bobasaurus/lumber-plunder-metal-detector/kicad/metal detector test/stm32 nucleo board jumpers and solder bridges.xlsx

nucleo-f303k8 (STM32F303K8T6) |  |  |  | (powered using VIN pin at 11.1V nominally, nucleo supports 7-12V on that pin officially, max nucleo current < 300 mA
 |  |  |  | When powered from VIN or +5 V, it is still possible to use ST-LINK for communication for programming or debugging only, but it is mandatory to power the board first, using VIN or +5 V, then to connect the USB cable to the PC.
(on nucleo) | (TRUE = on/connected/soldered/bridged)
Jumper | Default | Desired | change? | Function | Notes
SB1 | FALSE | FALSE |  | off = tells host pc that up to 300 mA max will be drawn from USB power, on = only 100 mA max will be drawn (makes USB enumeration suceed more often) | Must be off for VIN power
SB2 | TRUE | TRUE |  | on = PA2 operates as backchannel TX, off = PA2 operates as A7 pin and is disconnected from ST-LINK | lumber plunder's SW6 will only work if this jumper is off and LP_JP2 is on. Defaulting to enable backchannel tx for initial debugging, will change this later | IS ACCESSABLE AFTER SOLDERING NUCLEO
SB3 | TRUE | TRUE |  | on = PA15 operates as backchannel RX, off = PA15 is not connected | not connected to any header pins, no conflict
SB4 | FALSE | TRUE | yes |  | MCO 8 MHz from ST-LINK connected to OSCIN (PF0)
SB5 | FALSE | FALSE |  |  | MCO 8 MHz from ST-LINK connected to OSCIN (PF0)
SB6 | TRUE | FALSE | yes |  | MCO 8 MHz from ST-LINK connected to OSCIN (PF0)
SB7 | FALSE | FALSE |  |  | MCO 8 MHz from ST-LINK connected to OSCIN (PF0)
SB8 | TRUE | TRUE |  |  | MCO 8 MHz from ST-LINK connected to OSCIN (PF0)
SB9 | TRUE | TRUE |  | on = NRST from ST-LINK connected to STM32 (normal operation), off = NRST disconnected for powering from 3.3V or 5V pins
SB10 | TRUE | TRUE |  | on = VREF+ on STM32 is connected to nucleo 3.3v regulator, off = disconnect nucleo 3.3v reg from vref and use external pin's vref instead (see LP_JP5) | lumber plunder's LP_JP5 must be off if this jumper is on, and vice versa. Defaulting to using the nucleo's internal vref for now... will try changing it later to see if it affects stability. | NOTE: NOT ACCESSABLE AFTER SOLDERING NUCLEO!!!
SB11 | TRUE | TRUE |  | on = PB2 is grounded, off = PB2 is open | not connected to any header pins, no conflict
SB12 | TRUE | TRUE |  | on = pin 31 is pulled to gnd for boot0 | not connected to any header pins, no conflict
SB13 | TRUE | TRUE |  | on = Pin 32 of STM32 (U2) is connected to VSS | not connected to any header pins, no conflict
SB14 | TRUE | TRUE |  | on = use internal 3.3v regulator for uC VDD, off = disconnect internal regulator
SB15 | TRUE | FALSE | yes | on = Green user LED LD3 is connected to D13, off = D13 is available to use as gpio | we need this for oled spi, so change to the open position
SB16 | TRUE | FALSE | yes | on = STM32 PB6 is connected to both A5 and D5 for I2C support and D5 is unusable, off = PB6 is just for D5 gpio | we need this open to use D5 for SW0 and A5 for audio dac output
SB17 | FALSE | FALSE |  |  | MCO 8 MHz from ST-LINK connected to OSCIN (PF0)
SB18 | TRUE | FALSE | yes | on = PB7 is connected to both A4A and D4 for I2C support and D4 is unusable, off = PB7 is just for D4 gpio | we need this for SW1, so change to the open position
JP1 | TRUE | TRUE |  | on = STM32 is powered, off = an ammeter must be connected for STM32 power | (on bottom of board, 90 deg connector) Labeled IDD, used to measure the STM32 microcontroller consumption by removing the jumper and connecting an ammeter
Lumber Plunder PCB Jumpers
Jumper | Default | Desired | change? | Function | Notes
LP_JP1 | FALSE | FALSE |  | on = 9v power connected to the analog transmit oscillator, off = analog transmit oscillator unpowered
LP_JP2 | FALSE | FALSE |  | on = SW6 connected... be sure to open SB2 backchannel tx jumper on nucleo, off = SW6 disconnected so we can use backchannel tx | Defaulting to enable backchannel tx for initial debugging, will change this later
LP_JP3 | FALSE | TRUE | yes | on = use nucleo 5v to power oled (jumper near nucleo) (must be opposite state of LP_JP4)
LP_JP4 | FALSE | FALSE |  | on = use nucleo 3.3v to power oled (must be opposite state of LP_JP3 and LP_JP6)
LP_JP5 | FALSE | FALSE |  | on = use lumber plunder's analog 3.3v as vref, off = use internal nucleo 3.3V regulator for vref | Leave this off for now to see how well the nucleo's reference does... then compare later to my analog 3.3v. The internal nucleo 3.3v goes through a series inductor at least.
LP_JP6 | FALSE | TRUE | yes | on = use nucleo 5v to power oled (jumper near nucleo) (must be opposite state of LP_JP4)
