bobasaurus/lumber-plunder-metal-detector/visual studio/sine_wave_resolution_test/sine_wave_resolution_test/dac test.xlsx

dac count | dac voltage [V]
0 | 0 |  | volts per dac step: | 0.0008056640625
1 | 0.0008058608059 |  | max voltage | 1.722124542
2 | 0.001611721612 |  | min voltage | 1.577069597
3 | 0.002417582418 |  | peak to peak voltage of sine wave generator: | 0.1450549451
4 | 0.003223443223 |  | number of steps peak to peak: | 180.043956
5 | 0.004029304029 |  | number of steps center to peak: | 90.02197802
6 | 0.004835164835
7 | 0.005641025641
8 | 0.006446886447
9 | 0.007252747253
10 | 0.008058608059
11 | 0.008864468864
12 | 0.00967032967
13 | 0.01047619048
14 | 0.01128205128
15 | 0.01208791209
16 | 0.01289377289
17 | 0.0136996337
18 | 0.01450549451
19 | 0.01531135531
20 | 0.01611721612
21 | 0.01692307692
22 | 0.01772893773
23 | 0.01853479853
24 | 0.01934065934
25 | 0.02014652015
26 | 0.02095238095
27 | 0.02175824176
28 | 0.02256410256
29 | 0.02336996337
30 | 0.02417582418
31 | 0.02498168498
32 | 0.02578754579
33 | 0.02659340659
34 | 0.0273992674
35 | 0.02820512821
36 | 0.02901098901
37 | 0.02981684982
38 | 0.03062271062
39 | 0.03142857143
40 | 0.03223443223
41 | 0.03304029304
42 | 0.03384615385
43 | 0.03465201465
44 | 0.03545787546
45 | 0.03626373626
46 | 0.03706959707
47 | 0.03787545788
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
