bobasaurus/lumber-plunder-metal-detector/images/lumber plunder metal detector schematic v1.pdf

# 6W Audio Amplifier for Transmitter

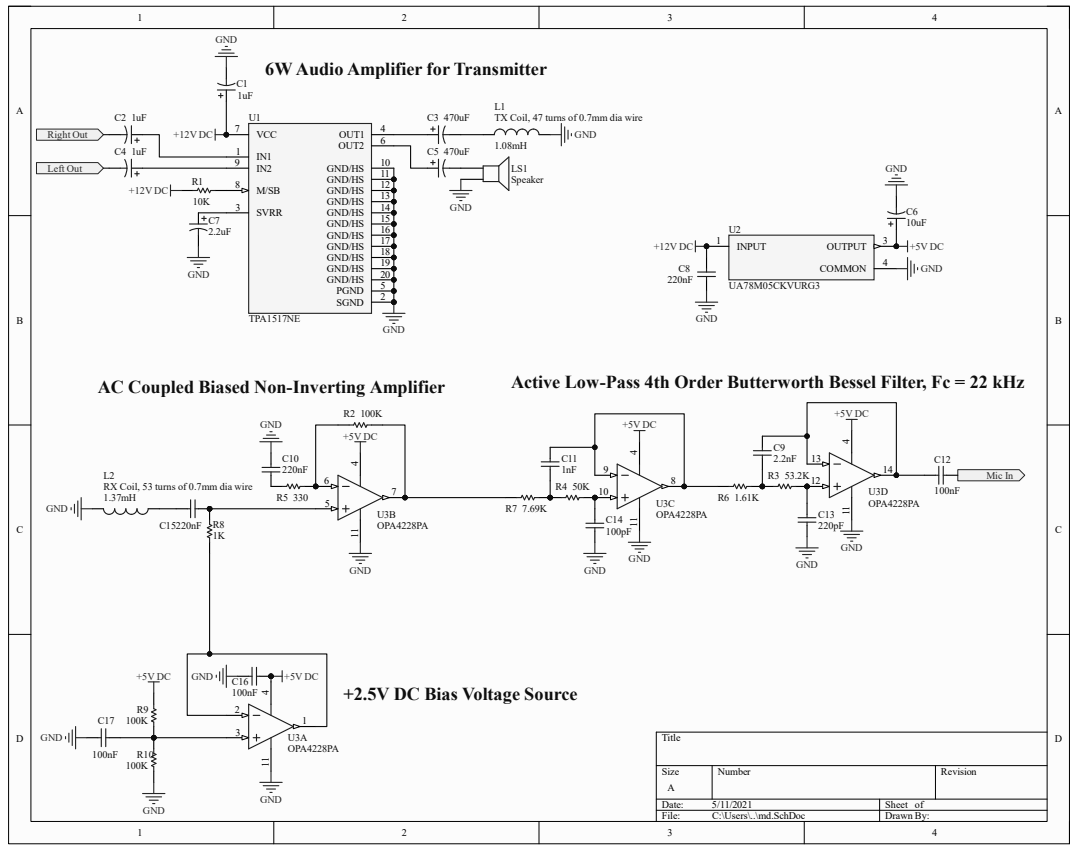
[picture p6: page 1]

TX Coil, 47 turns of 0.7mm dia wire

RX Coil, 53 turns of 0.7mm dia wire

+2.5V DC Bias Voltage Source
