bobasaurus/lumber-plunder-metal-detector/ltspice/metal detector tx range test.asc

C1: cap; 43n
C2: cap; 33n
Lrx: ind2; 6m1
Ltx: ind2; 5m9
Q1: npn
Q2: pnp
R1: res; 560
R2: res; 1k2
R3: res; 27k
R4: res; 12k
R5: res; 2k
R6: res; 18k
R7: res; 100k
R8: res; 5k1
R9: res; 5k1
R10: res; 50k
R11: res; 50k
R12: res; 100k
R13: res; 18k
U1: opamp
U2: opamp
V1: voltage; 9
V2: voltage; 1.65
V3: voltage; 9
Named nets: 0, VOutTxADC, VTxOsc, VOutRxADC
.tran 0 20m 12m 1u
.lib opamp.sub
.meas TRAN txVoltageForADCMax MAX V(VOutTxADC)
.meas TRAN txVoltageForADCMin MIN V(VOutTxADC)
.meas TRAN rxVoltageForADCMax MAX V(VOutRxADC)
.meas TRAN rxVoltageForADCMin MIN V(VOutRxADC)
K1 Ltx Lrx .001
todo: resistor divider for U1 bias, then use uC DAC for U2 bias
