bobasaurus/lumber-plunder-metal-detector/ltspice/diff amp.asc

R1: res; 10k
R2: res; 10k
R3: res; 50k
R4: res; 50k
RL: res; 1m
U1: opamp
V2: voltage; SINE(0 .1 10000)
Named nets: 0
.tran 0 1m 0 1u
.lib opamp.sub
