bobasaurus/lumber-plunder-metal-detector/ltspice/metal detector 5v proto.asc

C1: cap; 47n
C2: cap; 33n
Lrx: ind2; 6m2; Rser=25.3
Ltx: ind2; 5m6; Rser=24.5
Q1: npn; 2N3904
Q2: pnp; 2N3906
R1: res; 390
R2: res; 1k
R3: res; 47k
R4: res; 47k
R5: res; 1.5k
R6: res; 20k
R7: res; 100k
R8: res; 2.5k
R9: res; 2.5k
R10: res; 200k
R11: res; 200k
U1: opamp
U2: opamp
V1: voltage; 4.7
V2: voltage; 1.65
Named nets: 0, VOutTxADC, VTxOsc, VOutRxADC
.tran 0 40m 15m 10u
.lib opamp.sub
.meas TRAN txVoltageForADCMax MAX V(VOutTxADC)
.meas TRAN txVoltageForADCMin MIN V(VOutTxADC)
.meas TRAN rxVoltageForADCMax MAX V(VOutRxADC)
.meas TRAN rxVoltageForADCMin MIN V(VOutRxADC)
K1 Ltx Lrx .001
.meas TRAN VTxOsc_MAX MAX V(VTxOsc)
