bobasaurus/lumber-plunder-metal-detector/ltspice/two transistor oscillator.asc

C1: cap; 43n
L1: ind; 5m9
Q1: npn
Q2: pnp
R1: res; 560
R2: res; 1k2
R3: res; 27k
R4: res; 12k
R5: res; 2k
R9: res; 19k
R10: res; 100k
U1: opamp
V1: voltage; 9
V2: voltage; 1.4
Named nets: 0, Vout, Vosc
.tran 0 18m 16m 1u
.lib opamp.sub
.meas TRAN maxOutputVoltage MAX V(Vout)
.meas TRAN minOutputVoltage MIN V(Vout)
