bobasaurus/lumber-plunder-metal-detector/kicad/metal detector test/metal detector test.kicad_pcb

## KiCad design kicad/metal detector test/metal detector test.kicad_pcb (2023-10-08)

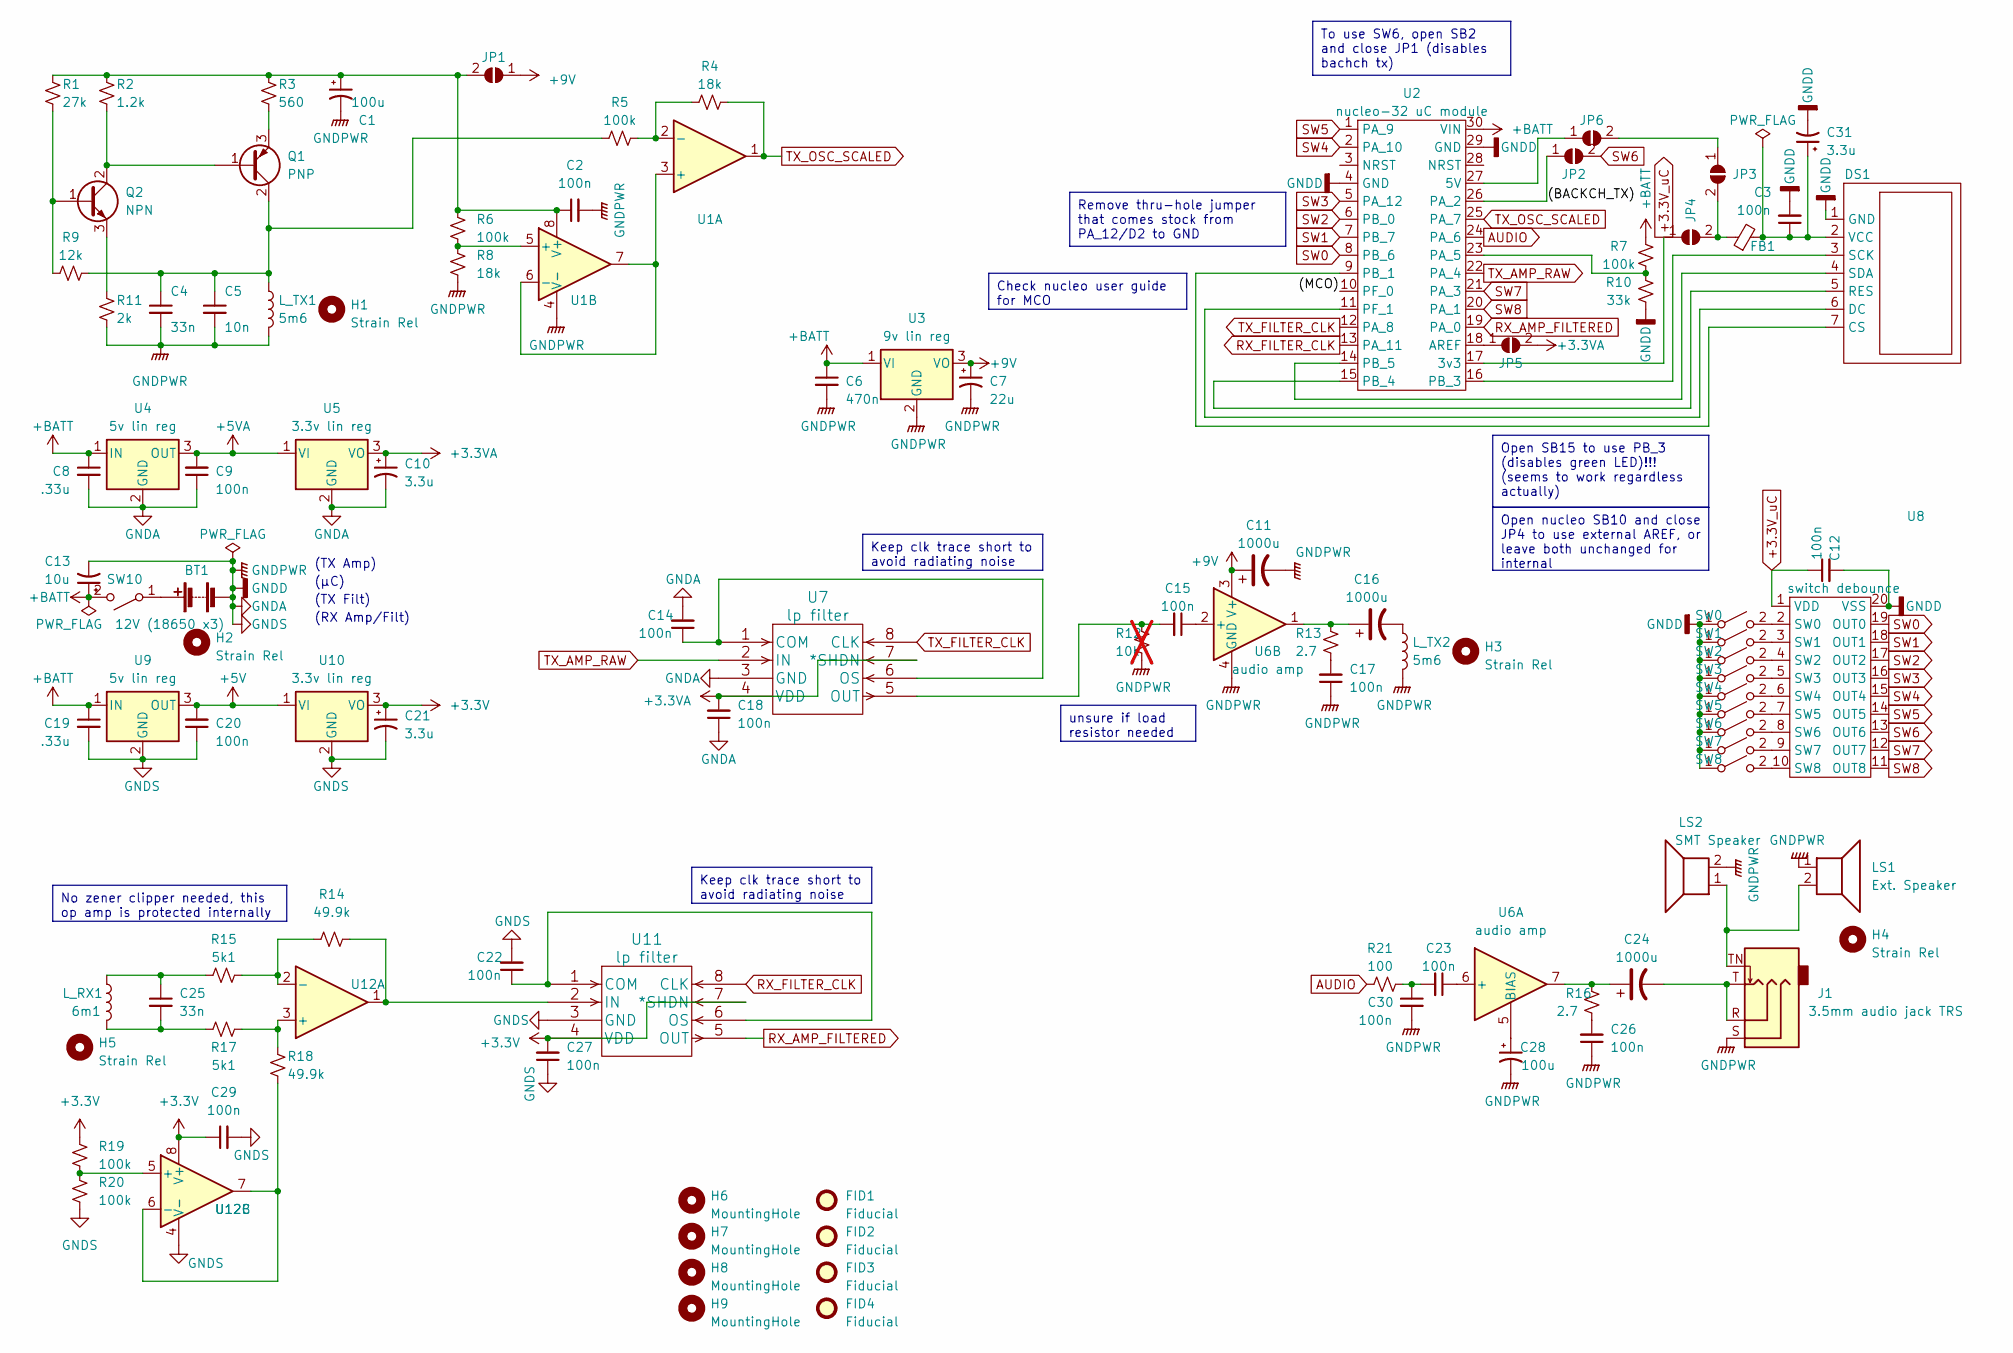
[picture p7: schematic metal detector test.kicad_sch, Lumber Plunder Metal Detector]

Parts:
BT1: 12V (18650 x3); PinHeader_1x02_P2.54mm_Vertical; MPN 106990288
C1, C28: 100u; C_Polarized_1206_3216Metric_HandSolder_allen
C2, C3, C9, C12, C14, C15, C17, C18, C20, C22, C23, C26, C27, C29, C30: 100n; C_0805_2012Metric_Pad1.18x1.45mm_HandSolder
C4, C25: 33n; C_0805_2012Metric_Pad1.18x1.45mm_HandSolder
C5: 10n; C_0805_2012Metric_Pad1.18x1.45mm_HandSolder
C6: 470n; C_1206_3216Metric_Pad1.33x1.80mm_HandSolder
C7: 22u; C_Polarized_1206_3216Metric_HandSolder_allen
C8, C19: .33u; C_0805_2012Metric_Pad1.18x1.45mm_HandSolder
C10, C21, C31: 3.3u; C_Polarized_0805_2012Metric_HandSolder_allen
C11, C16, C24: 1000u; CP_Radial_D10.0mm_P5.00mm; MPN A750MV108M1EAAE014
C13: 10u; C_Polarized_1206_3216Metric_HandSolder_allen
DS1: 2.42_inch_128x64_oled; oled_2.42in_128x64; MPN B09LND6QJ1
FB1: ferrite bead smt; L_0805_2012Metric_Pad1.05x1.20mm_HandSolder; MPN HZ0805E601R-10
FID1, FID2, FID3, FID4: Fiducial; Fiducial_0.5mm_Mask1.5mm
H1, H2, H3, H4, H5: Strain Rel; mounting_hole_3mm
H6, H7, H8, H9: MountingHole; mounting_hole_4-40_thru
J1: 3.5mm audio jack TRS; SJ-3524-SMT_audio_jack_with_tip_switch_smt; MPN SJ-3524-SMT
JP1: SolderJumper_2_Open_big; SolderJumper-2_Open_big_allen
JP2, JP3, JP4, JP5, JP6: SolderJumper_2_Open; SolderJumper-2_P1.3mm_Open_Pad1.0x1.5mm
LS1: Ext. Speaker; PinHeader_1x02_P2.54mm_Vertical
LS2: SMT Speaker; CDS-13138-SMT-TR_speaker_smt; MPN CDS-13138-SMT-TR
L_RX1: 6m1; PinHeader_1x02_P2.54mm_Vertical
L_TX1, L_TX2: 5m6; PinHeader_1x02_P2.54mm_Vertical
Q1: PNP; SOT-89-3_Handsoldering_allen; MPN 2SA2071T100Q
Q2: NPN; SOT-89-3_Handsoldering_allen; MPN 2SC5824T100Q
R1: 27k; R_0805_2012Metric_Pad1.20x1.40mm_HandSolder
R2: 1.2k; R_0805_2012Metric_Pad1.20x1.40mm_HandSolder
R3: 560; R_0805_2012Metric_Pad1.20x1.40mm_HandSolder
R4, R8: 18k; R_0805_2012Metric_Pad1.20x1.40mm_HandSolder
R5, R6, R7, R19, R20: 100k; R_0805_2012Metric_Pad1.20x1.40mm_HandSolder
R9: 12k; R_0805_2012Metric_Pad1.20x1.40mm_HandSolder
R10: 33k; R_0805_2012Metric_Pad1.20x1.40mm_HandSolder
R11: 2k; R_0805_2012Metric_Pad1.20x1.40mm_HandSolder
R12: 10k; R_0805_2012Metric_Pad1.20x1.40mm_HandSolder; not fitted
R13, R16: 2.7; R_0805_2012Metric_Pad1.20x1.40mm_HandSolder
R14, R18: 49.9k; R_0805_2012Metric_Pad1.20x1.40mm_HandSolder
R15, R17: 5k1; R_0805_2012Metric_Pad1.20x1.40mm_HandSolder
R21: 100; R_0805_2012Metric_Pad1.20x1.40mm_HandSolder
SW0, SW1, SW2, SW3, SW4, SW5, SW6, SW7, SW8: SW_SPST; SW_SPST_PTS647; MPN PTS 647 SN50 SMTR2 LFS
SW10: SW_SPST; A11AH_right_angle_toggle_switch; MPN A11AH
U1: op amp (higher voltage); SOIC-8_3.9x4.9mm_P1.27mm; MPN OPA2140AID
U2: nucleo-32 uC module; Nucleo-32_allen; MPN NUCLEO-F303K8
U3: 9v lin reg; SOT-223-3_TabPin2; MPN LM2940IMP-9.0/NOPB
U4, U9: 5v lin reg; SOT-223-3_TabPin2; MPN UA78M05CDCYRG3
U5, U10: 3.3v lin reg; SOT-223-3_TabPin2; MPN LT1129CST-3.3#PBF
U6: audio amp; TO-263-7_TabPin4; MPN LM4752TS
U7, U11: lp filter; TSSOP-8_4.4x3mm_P0.65mm; MPN MAX7423EUA+
U8: switch debounce; SOIC-20W_7.5x12.8mm_P1.27mm; MPN LS20-S
U12: op amp (lower voltage); SOIC-8_3.9x4.9mm_P1.27mm; MPN OPA2320AID

Connections:
+3.3V: C21.1, C27.2, C29.1, R19.1, U10.3 (VO), U11.4 (VDD), U11.7 (*SHDN), U12.8 (V+)
+3.3VA: C10.1, C18.2, JP5.2 (B), U5.3 (VO), U7.4 (VDD), U7.7 (*SHDN)
+3.3V_uC: C12.1, JP4.1 (A), U2.17 (3v3), U8.1 (VDD)
+5V: C20.2, U9.3 (OUT), U10.1 (VI)
+5VA: C9.2, U4.3 (OUT), U5.1 (VI)
+9V: C7.1, C11.1, JP1.1 (A), U3.3 (VO), U6.3 (V+)
+BATT: C6.1, C8.1, C13.1, C19.1, R7.1, SW10.2 (B), U2.30 (VIN), U3.1 (VI), U4.1 (IN), U9.1 (IN)
/(BACKCH_TX): JP2.1 (A), U2.26 (PA_2)
/(MCO): U2.10 (PF_0)
AUDIO: R21.1, U2.24 (PA_6)
GNDA: BT1.2 (-), C1.2, C2.2, C3.2, C4.2, C5.2, C6.2, C7.2, C8.2, C9.1, C10.2, C11.2, C12.2, C13.2, C14.2, C17.1, C18.1, C19.2, C20.1, C21.2, C22.2, C26.1, C27.1, C28.2, C29.2, C30.2, C31.2, DS1.1 (GND), J1.S, LS1.1, LS2.2, L_TX1.2, L_TX2.2, R8.2, R10.2, R11.2, R12.2, R20.2, SW0.1 (A), SW1.1 (A), SW2.1 (A), SW3.1 (A), SW4.1 (A), SW5.1 (A), SW6.1 (A), SW7.1 (A), SW8.1 (A), U1.4 (V-), U2.4 (GND), U2.29 (GND), U3.2 (GND), U4.2 (GND), U5.2 (GND), U6.4 (GND), U7.3 (GND), U8.20 (VSS), U9.2 (GND), U10.2 (GND), U11.3 (GND), U12.4 (V-)
unnamed: BT1.1 (+), SW10.1 (A)
unnamed: C16.1, R13.1, U6.1
unnamed: C16.2, L_TX2.1
unnamed: C17.2, R13.2
unnamed: C23.2, C30.1, R21.2
unnamed: C24.1, R16.1, U6.7
unnamed: C24.2, J1.R, J1.T
unnamed: C25.1, L_RX1.1, R15.1
unnamed: C25.2, L_RX1.2, R17.1
unnamed: C26.2, R16.2
unnamed: DS1.7 (CS), U2.9 (PB_1)
unnamed: DS1.6 (DC), U2.11 (PF_1)
unnamed: DS1.5 (RES), U2.15 (PB_4)
unnamed: DS1.3 (SCK), U2.16 (PB_3)
unnamed: DS1.4 (SDA), U2.14 (PB_5)
unnamed: C3.1, C31.1, DS1.2 (VCC), FB1.2
unnamed: J1.TN, LS1.2, LS2.1
unnamed: C1.1, C2.1, JP1.2 (B), R1.1, R2.1, R3.1, R6.1, U1.8 (V+)
unnamed: JP3.1 (A), JP6.2 (B)
unnamed: FB1.1, JP3.2 (B), JP4.2 (B)
unnamed: JP5.1 (A), U2.18 (AREF)
unnamed: JP6.1 (A), U2.27 (5V)
unnamed: Q1.1 (B), Q2.2 (C), R2.2
unnamed: C4.1, C5.1, L_TX1.1, Q1.2 (C), R5.1, R9.1
unnamed: Q1.3 (E), R3.2
unnamed: Q2.1 (B), R1.2, R9.2
unnamed: Q2.3 (E), R11.1
unnamed: SW0.2 (B), U8.2 (SW0)
unnamed: SW1.2 (B), U8.3 (SW1)
unnamed: SW2.2 (B), U8.4 (SW2)
unnamed: SW3.2 (B), U8.5 (SW3)
unnamed: SW4.2 (B), U8.6 (SW4)
unnamed: SW5.2 (B), U8.7 (SW5)
unnamed: SW6.2 (B), U8.8 (SW6)
unnamed: SW7.2 (B), U8.9 (SW7)
unnamed: SW8.2 (B), U8.10 (SW8)
unnamed: U1.3 (+), U1.6 (-), U1.7
unnamed: R4.1, R5.2, U1.2 (-)
unnamed: R6.2, R8.1, U1.5 (+)
unnamed: R7.2, R10.1, U2.23 (PA_5)
unnamed: C23.1, U6.6 (+)
unnamed: C28.1, U6.5 (BIAS)
unnamed: C15.1, U6.2 (+)
unnamed: C14.1, U7.1 (COM), U7.6 (OS)
unnamed: C15.2, R12.1, U7.5 (OUT)
unnamed: C22.1, U11.1 (COM), U11.6 (OS)
unnamed: R14.2, U11.2 (IN), U12.1
unnamed: R17.2, R18.1, U12.3 (+)
unnamed: R14.1, R15.2, U12.2 (-)
unnamed: R19.2, R20.1, U12.5 (+)
unnamed: R18.2, U12.6 (-), U12.7
RX_AMP_FILTERED: U2.19 (PA_0), U11.5 (OUT)
RX_FILTER_CLK: U2.13 (PA_11), U11.8 (CLK)
SW0: U2.8 (PB_6), U8.19 (OUT0)
SW1: U2.7 (PB_7), U8.18 (OUT1)
SW2: U2.6 (PB_0), U8.17 (OUT2)
SW3: U2.5 (PA_12), U8.16 (OUT3)
SW4: U2.2 (PA_10), U8.15 (OUT4)
SW5: U2.1 (PA_9), U8.14 (OUT5)
SW6: JP2.2 (B), U8.13 (OUT6)
SW7: U2.21 (PA_3), U8.12 (OUT7)
SW8: U2.20 (PA_1), U8.11 (OUT8)
TX_AMP_RAW: U2.22 (PA_4), U7.2 (IN)
TX_FILTER_CLK: U2.12 (PA_8), U7.8 (CLK)
TX_OSC_SCALED: R4.2, U1.1, U2.25 (PA_7)

Notes on the sheet:
Open nucleo SB10 and close JP4 to use external AREF, or leave both unchanged for internal
Remove thru-hole jumper that comes stock from PA_12/D2 to GND
No zener clipper needed, this op amp is protected internally
Keep clk trace short to avoid radiating noise
To use SW6, open SB2 and close JP1 (disables bachch tx)
Open SB15 to use PB_3 (disables green LED)!!! (seems to work regardless actually)
unsure if load resistor needed
Check nucleo user guide for MCO
(µC)
(TX Amp)
(TX Filt)
(RX Amp/Filt)

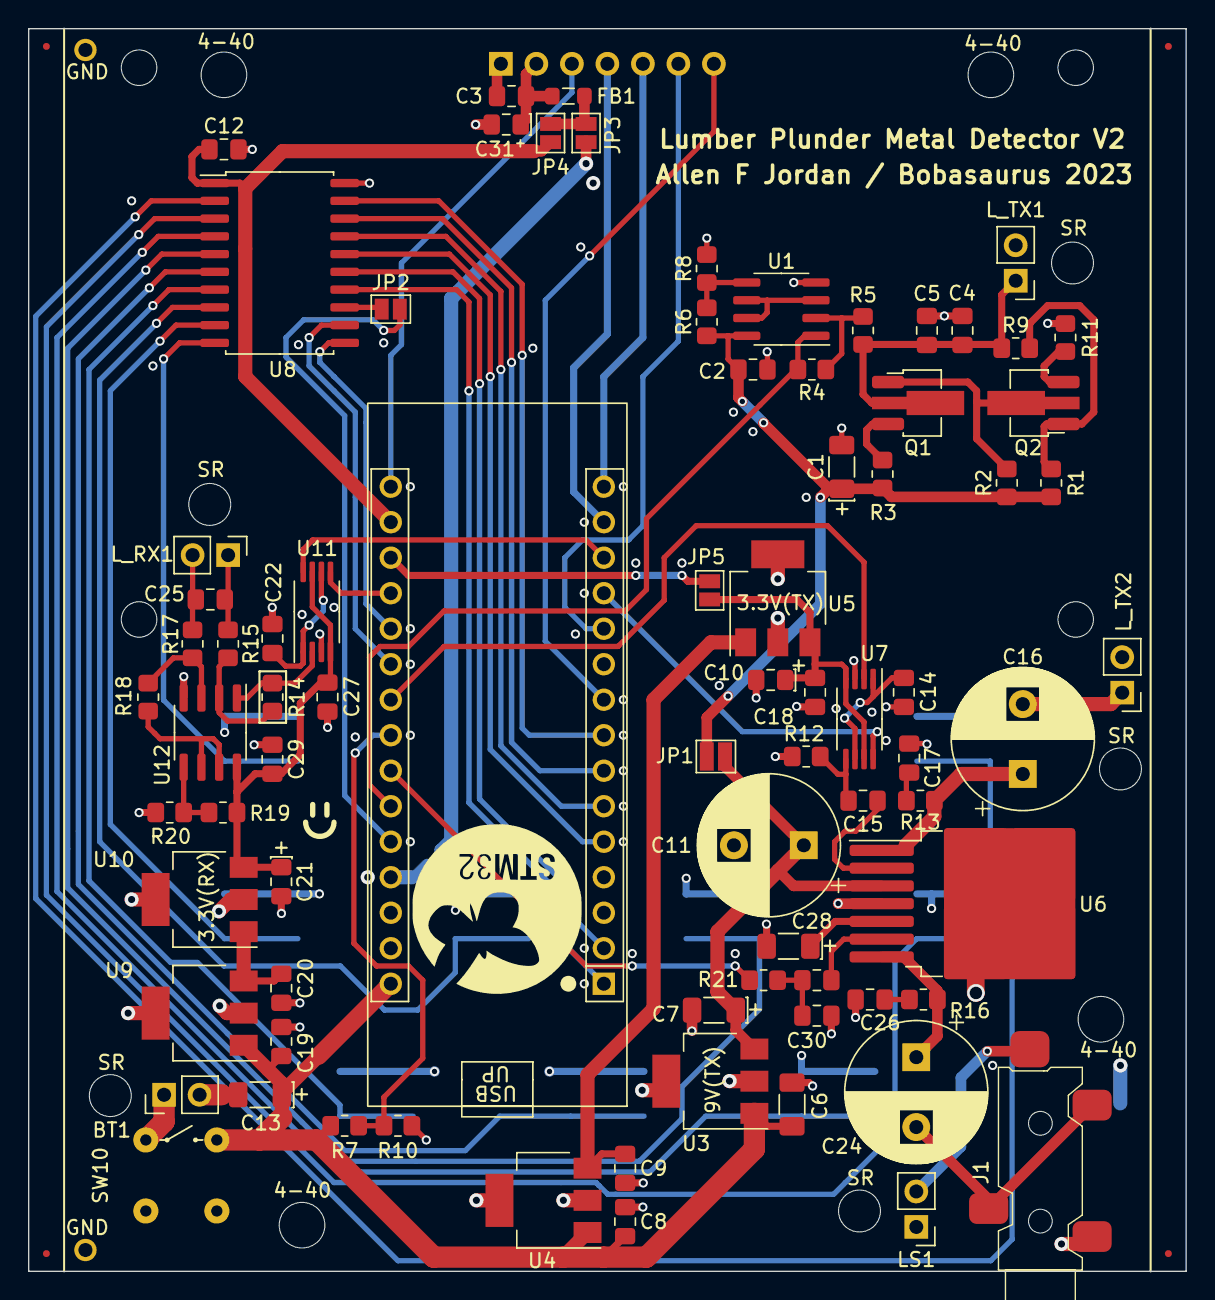
[picture p8: board metal detector test.kicad_pcb from above]

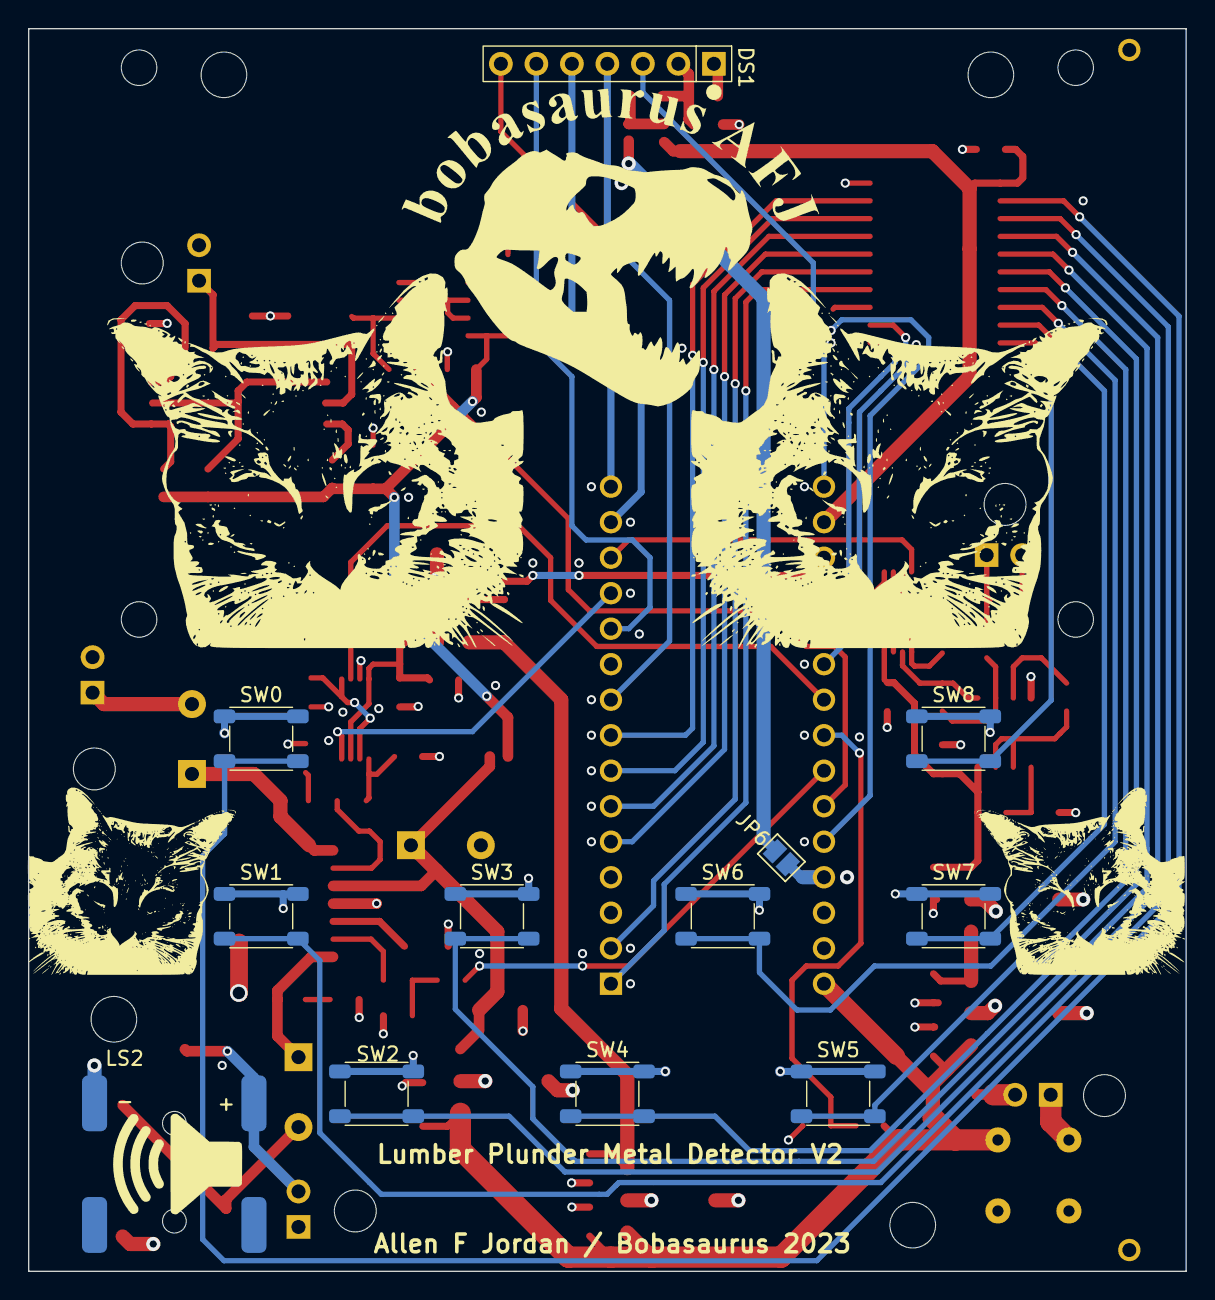
[picture p9: board metal detector test.kicad_pcb from below]

Board: 4 copper layers, 82.8 x 88.9 mm, 105 parts (13 on the bottom side), 75 nets.

Other parts of the board:
bobasaurus_logo: LOGO
