bobasaurus/lumber-plunder-metal-detector/stm32cubeide/dac_dma/Core/Src/main.c

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
/* Includes ------------------------------------------------------------------*/
#include "main.h"

DAC_HandleTypeDef hdac1;
DMA_HandleTypeDef hdma_dac1_ch1;

TIM_HandleTypeDef htim6;

UART_HandleTypeDef huart2;

/* USER CODE BEGIN PV */

const uint32_t waveSampleRate = 5333333;
const double waveFrequency = 10000;
const double waveAmplitude = 2047.5;
const double waveCenter = 2047.5;

#define WAVE_BUFFER_CAPACITY 800	//way bigger than needed
uint32_t waveSize;//[points]
uint16_t waveBuffer[WAVE_BUFFER_CAPACITY];

/* USER CODE END PV */

void SystemClock_Config(void);
static void MX_GPIO_Init(void);
static void MX_DMA_Init(void);
static void MX_USART2_UART_Init(void);
static void MX_DAC1_Init(void);
static void MX_TIM6_Init(void);
/* USER CODE BEGIN 0 */

/**
 * sampleRate [samples/second]
 * frequency [Hz]
 * amplitude [12-bit DAC counts]
 * center [12-bit DAC counts]
 */
int GenerateWaveToTransmit(double sampleRate, double frequency, double amplitude, double center)
{
    double sampleTime = 1.0 / sampleRate;//[sec/sample]
    uint32_t samplesPerCycle = (uint32_t)round(sampleRate / frequency);

    if (samplesPerCycle >= WAVE_BUFFER_CAPACITY) return 2;

    for (uint32_t i = 0; i < samplesPerCycle; i++)
    {
        double timeS = (i) * sampleTime;
        double waveValue = amplitude * sin(2 * M_PI * frequency * timeS) + center;
        uint16_t waveValueInt = (uint16_t)round(waveValue);
        if (waveValueInt < 0) return -1;//waveValue = 0;//TODO: test and see if I can remove this
		if (waveValueInt > 4095) return 1;//waveValue = 4095;
        waveBuffer[i] = waveValueInt;
    }

    waveSize = samplesPerCycle;

    return 0;
}


/* USER CODE END 0 */

/**
  * @brief  The application entry point.
  * @retval int
  */
int main(void)
{

  /* MCU Configuration--------------------------------------------------------*/

  /* Reset of all peripherals, Initializes the Flash interface and the Systick. */
  HAL_Init();

  /* Configure the system clock */
  SystemClock_Config();

  /* Initialize all configured peripherals */
  MX_GPIO_Init();
  MX_DMA_Init();
  MX_USART2_UART_Init();
  MX_DAC1_Init();
  MX_TIM6_Init();
  /* USER CODE BEGIN 2 */

  if (GenerateWaveToTransmit(waveSampleRate, waveFrequency, waveAmplitude, waveCenter) != 0)
	  while (1) {}

  //HAL_DAC_Start(&hdac1, DAC_CHANNEL_1);

  HAL_TIM_Base_Start(&htim6);

  /*
   * Configures the DAC channel for DMA operation.
   * Links the DMA transfer from the memory buffer (dacBuffer) to the DAC data register.
   * Starts both the DAC and the DMA in one call.
   */
  HAL_StatusTypeDef status = HAL_DAC_Start_DMA(&hdac1, DAC_CHANNEL_1, (uint32_t*)waveBuffer, waveSize, DAC_ALIGN_12B_R);



  int test = 1;
  test++;
  //hdma_dac1_ch1.Instance
  //hdma_dac1_ch1.DmaBaseAddress
  //HAL_DMA_Start(&hdma_dac1_ch1, (uint32_t) waveBuffer, (uint32_t)&hdac1.Instance->DHR12R1, (uint32_t) waveSize);
  //__HAL_DAC_ENABLE_DMA(&hdac1, DAC_CHANNEL_1);

  //uint16_t i = 0;
  //uint32_t timeOffset = 0;
  //uint16_t j = 0;
  //uint16_t value;
  //while (1)
  //{
	  //value = waveBuffer[i++];
	  //HAL_DAC_SetValue(&hdac1, DAC_CHANNEL_1, DAC_ALIGN_12B_R, (uint32_t) value);
	  //if (i >= waveSize) i = 0;
  //}

  /* USER CODE END 2 */

  /* Infinite loop */
  /* USER CODE BEGIN WHILE */
  while (1)
  {
    /* USER CODE END WHILE */

    /* USER CODE BEGIN 3 */
  }
  /* USER CODE END 3 */
}

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
