bobasaurus/lumber-plunder-metal-detector/stm32cubeide/dac_dma/dac_dma.ioc

Mcu.UserName=STM32F303K8Tx
PA13.GPIO_Label=SWDIO
PA13.Signal=SYS_JTMS-SWDIO
PA14.GPIO_Label=SWCLK
PA14.Signal=SYS_JTCK-SWCLK
PA15.GPIO_Label=VCP_RX
PA15.Signal=USART2_RX
PA2.GPIO_Label=VCP_TX
PA2.Signal=USART2_TX
PA4.Signal=COMP_DAC11_group
