bobasaurus/lumber-plunder-metal-detector/stm32cubeide/wave_test/Core/Inc/maincpp.h

/*
 * maincpp.h
 *
 *  Created on: Nov 7, 2023
 *      Author: blah
 */

#ifndef INC_MAINCPP_H_
#define INC_MAINCPP_H_

#include "stm32f3xx_hal.h"
#include <cmath>
#include <cstring>

#include "printf.h"
#include "main.h"

extern "C" int maincpp(void);

#endif /* INC_MAINCPP_H_ */
