bobasaurus/lumber-plunder-metal-detector/(commit log)

2022-02-10 Added some images and a schematic link
2022-02-22 working on improving audio latency, temporarily have phase graph disabled. May be a lag introduced on long run times currently that gets larger and larger, needs testing.
2022-11-26 Working on a pcb in kicad for V2 of this metal detector.
    [metal detector test.kicad_pcb, metal detector test.kicad_sch]
2022-11-26 moving kicad libs
2022-11-26 Added TI's part library for their OPA2156IDR op amp
    [metal detector test.kicad_sch]
2022-11-26 Added ltspice simulation tests, also another part library for kicad
    [metal detector test.kicad_sch]
2022-11-27 Added transistor footprints
    [metal detector test.kicad_sch]
2022-12-18 working on schematic
    [metal detector test.kicad_sch]
2023-03-13 Most major parts of the schematic are done, need to figure out uC connections including DAC.
    [metal detector test.kicad_sch]
2023-03-13 made the 9v regulator's caps 1206, may need to do the same to the 5v
    [metal detector test.kicad_sch]
2023-03-15 Connected nucleo uC module, mostly done
    [metal detector test.kicad_sch]
2023-03-19 Added clipper and switches, may need to move clipper behind resistors
    [metal detector test.kicad_sch]
2023-03-19 Realized the rx op amp has a built in limiter so no need for the external zeners, plus they apparently create a significant temperature-dependent offset voltage so that's not great.
    [metal detector test.kicad_sch]
2023-03-21 Added battery voltage measurement and a big cap on the battery input
    [metal detector test.kicad_sch]
2023-03-24 Added smt ferrite bead and cap to gnd on oled power input since amazon review reported that it's noise bleeds back into the uC, also made power for it optionally come from 5v or 3.3v with solder jump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
    [metal detector test.kicad_pcb, metal detector test.kicad_sch]
2023-03-24 Tweaks to make ERC pass, and redid designator anotations
    [metal detector test.kicad_sch]
2023-03-24 part num for ferrite
    [metal detector test.kicad_sch]
2023-03-24 Finished adding footprints, made MPN field for manufacturer part number and populated it for each part, figured out push button part and footprint
    [metal detector test.kicad_sch]
2023-03-25 Starting PCB layout. Also added alternate MPNs for a few more regulators sampled from TI
    [metal detector test.kicad_pcb, metal detector test.kicad_sch]
2023-03-27 Working on pcb layout, generated BOM
    [metal detector test.kicad_pcb, metal detector test.kicad_sch, metal detector test_bom_V2.csv]
2023-03-30 slow progress
    [metal detector test.kicad_pcb, metal detector test.kicad_sch, metal detector test_bom_V2.csv]
2023-03-31 Added holes on corners of OLED footprint after carefully measuring twice, working on layout still.
    [metal detector test.kicad_pcb, metal detector test.kicad_sch]
2023-03-31 Making custom mounting / strain relief holes
    [metal detector test.kicad_pcb, metal detector test.kicad_sch]
2023-04-01 making progress on pcb layout
    [metal detector test.kicad_pcb, metal detector test.kicad_sch]
2023-04-02 Mostly positioned the parts
    [metal detector test.kicad_pcb, metal detector test.kicad_sch]
2023-04-02 small changes
    [metal detector test.kicad_pcb]
2023-04-04 Figuring out oled and battery holder placement
    [metal detector test.kicad_pcb, metal detector test.kicad_sch]
2023-04-06 most of the placement done
    [metal detector test.kicad_pcb]
2023-04-08 working on part positions still
    [metal detector test.kicad_pcb, metal detector test.kicad_sch]
2023-04-09 Realized that I was accidentially using a pin required to use the external 8 MHz MCO xtal signal passed from the debugger chip, changed to another one.
    [metal detector test.kicad_pcb, metal detector test.kicad_sch]
2023-04-09 Adding a test stm32 project that tries out the peripherals I need on the nucleo-32 board along with the OLED display
2023-04-15 considering filtering the audio output
    [metal detector test.kicad_pcb, metal detector test.kicad_sch]
2023-04-17 Swapped DAC outputs for better impedance balancing
    [metal detector test.kicad_pcb, metal detector test.kicad_sch]
2023-10-06 About halfway done routing tracks/traces
    [metal detector test.kicad_pcb, metal detector test.kicad_sch]
2023-10-07 Everything but gnd should be routed
    [metal detector test.kicad_pcb, metal detector test.kicad_sch]
2023-10-07 Finished routing I think, needs testing. Need to position designators as well.
    [metal detector test.kicad_pcb]
2023-10-07 via stitching, designator placement
    [metal detector test.kicad_pcb]
2023-10-08 Added a lot of fun silkscreen logos, and some other small tweaks
    [metal detector test.kicad_pcb, metal detector test.kicad_sch]
2023-10-08 Should be ready for fabrication
    [metal detector test.kicad_pcb, metal detector test.kicad_sch]
2023-10-08 Submitted for fabricaiton
    [metal detector test-B_Mask.gbs, metal detector test-B_Paste.gbp, metal detector test-B_Silkscreen.gbo, metal detector test-BackSigPwr_Cu.gbl, metal detector test-Edge_Cuts.gm1, metal detector test-F_Mask.gts, metal detector test-F_Paste.gtp, metal detector test-F_Silkscreen.gto]
2023-11-06 Figured out the complicated jumper / solder bridge settings, added a spreadsheet here with the results. The board won't work unless the jumpers are configured as in the spreadsheet.
    [stm32 nucleo board jumpers and solder bridges.xlsx]
2023-11-09 Rebuilt lumber plunder firmware project since I messed the first one's drivers up. This time I used my u8g2 example as a template so it imported all the right pins and clock/hw config.
2023-11-09 Basic hardware tests are working so far: oled, backchannel uart tx, battery voltage measurement on ADC2, all switches (except #6 since it's disabled while using backchannel tx)
2023-11-10 Battery voltage was reading low (ADC2), I noticed this on all ADC measurements on my earlier breadboard tests too. There is an ADC calibration available, but only when using the low level (LL) librar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
    [lumber_plunder_firmware.ioc, main.c, main.h, maincpp.cpp, maincpp.h]
2023-11-10 experimenting with adc cal delays
2023-12-31 figuring out dma
2023-12-31 still working out dma details
2024-01-02 The latest cube mx version puts the generated code mostly in a separate source file: stm32f3xx_hal_msp.c. Turns out it can auto-generate the DMA code, and it was very similar to what I was working on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
2024-01-02 still working on dma, ugh
2024-02-05 added a test project for using the dma and dac to generate a wave. May be working, though I don't know what rate the timer is running at
2024-02-07 Updated gitignore for extra stm32cubeide workspace folder that's probably not needed
2024-03-12 finally got the dac + dma + timer working to make beeps on the speaker
2024-03-12 Able to change the amplitude and frequency with button presses (kind of crudely). For some reason it sounds like there are some duplicate tones at higher frequencies, maybe a bug in the wave calculat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
    [main.c, main.h]
2024-03-12 Oops, the 8 MHz MCO clock from the ST-LINK loses power when USB is disconnected, killing the main uC. Switching back to internal oscillator (HSI) for now, will order a crystal and caps.
    [hal_dac_dma_timer.ioc, main.c]
2024-03-13 reduced amplitude change step size to test amplifier output... it looks like the audio amp is clipping at about 6v peak-to-peak, annoyingly.
2024-03-15 I think I have the timer output compare working for generating 2 MHz squarewaves on the two output pins that need it (timer 1 channels 1 and 4 for the filter chips).
2024-03-18 Got the X R simulation working well, also have a better I Q version. In the final code will likely replace the second derivative with a high pass filter, or combine all the filters into a bandpass
2024-03-21 The 'hal_dac_dma_timer_tx_amp_raw' project now outputs sine waves on both DAC channels and outputs squarewave clocks to both filter chips
2024-03-24 added a note about the 9v regulator's capacitor... turns out it can increase as large as needed
    [metal detector test.kicad_sch]
2024-03-25 There was a bug in the sine wave generator that added artifical decimation/steps, fixed now. Also just outputting tx_amp_raw for now.
    [hal_dac_dma_timer_tx_amp_raw.ioc, main.c]
2024-04-05 current state of test code, it's giving a weird waveform shape though
2024-04-13 increased timer clock significantly to test higher dac sine wave output frequencies
2024-12-30 Small changes from latest stm32cubeide, plus changed sample rate and amplitude/center of dac basic testing project.
    [dac_basic_testing Debug.cfg]
2024-12-30 adding a vs project to calculate the sine wave resolutions required to avoid missing dac steps
    [dac test.xlsx]
2024-12-31 Finally got a DMA/DAC example working. The "dac_dma" project is outputting a 10 kHz sine wave without any intervention from the main CPU. It turns out that a trigger is required, so I'm using Timer 6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
    [dac_basic_testing Debug.cfg]
